nicozorza/TP_Final_Embebidos/firmware_edu-ciaa/sapi_examples/documentation/docs/assets/pdf/sAPI-02-Diseño.pdf

Docs » Diseño

# Principios de diseño

Se basa en denir periféricos abstractos y lo más genéricos posibles, logrando independencia de la arquitectura. Esta independecia es deseada para que actúe como HAL (Hardware Abstraction Layer).

Se diseña además una API sencilla en la que la mayoría de las funciones son del tipo:

nombreModuloCong();
nombreModuloRead();
nombreModuloWrite();

Utiliza nombres sencillos al estilo de la biblioteca Wiring, pero en lugar del concepto de pin utiliza el concepto periférico, para lograr una API unicada, sin importar el número de pines que tenga un cierto perifécico.

## Capas de software
