nicozorza/TP_Final_Embebidos/Bitacora/imagenes/19 resultados con el ventilador.jpg

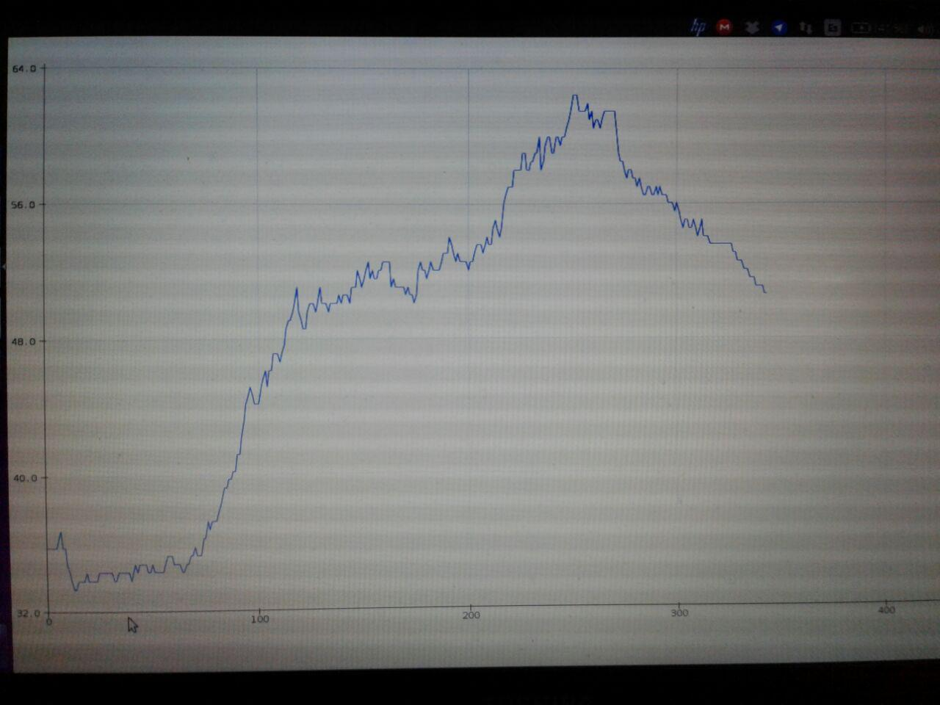
Bitacora/imagenes/19 resultados con el ventilador.jpg
