nicozorza/TP_Final_Embebidos/Bitacora/imagenes/20 resultados 200 grados.jpg

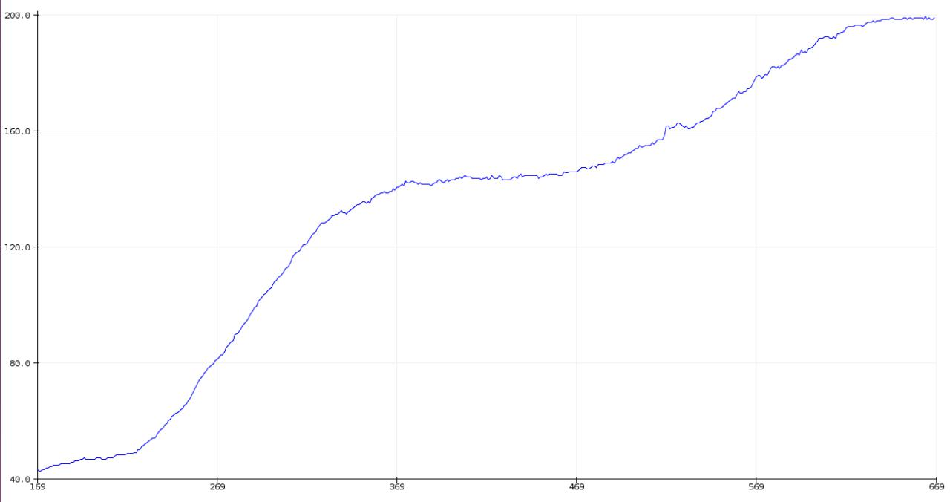
Bitacora/imagenes/20 resultados 200 grados.jpg
