nicozorza/TP_Final_Embebidos/Bitacora/imagenes/2 detector de fase senger.jpg

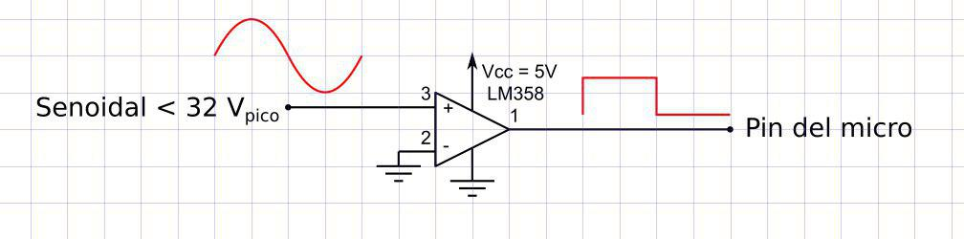
Bitacora/imagenes/2 detector de fase senger.jpg
