nicozorza/TP_Final_Embebidos/Bitacora/imagenes/3 detector de fase nuevo.jpg

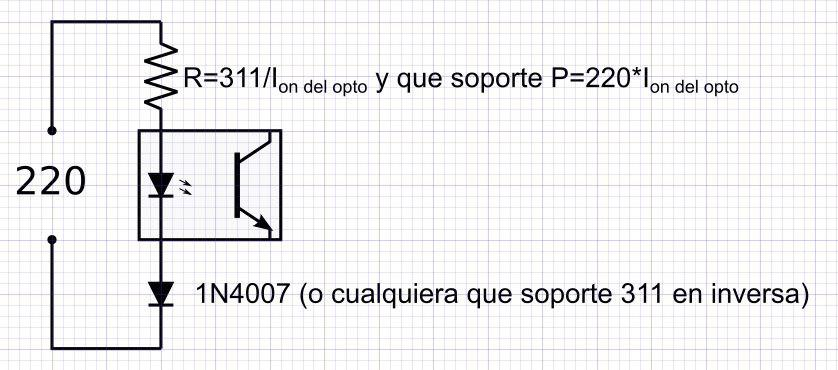
Bitacora/imagenes/3 detector de fase nuevo.jpg
