nicozorza/TP_Final_Embebidos/Bitacora/imagenes/12 termocupla.png

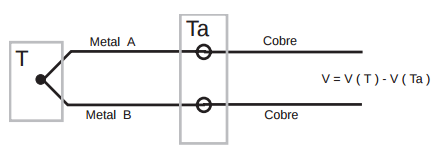
Bitacora/imagenes/12 termocupla.png
