nicozorza/TP_Final_Embebidos/Bitacora/imagenes/17 foto placa 1.jpg

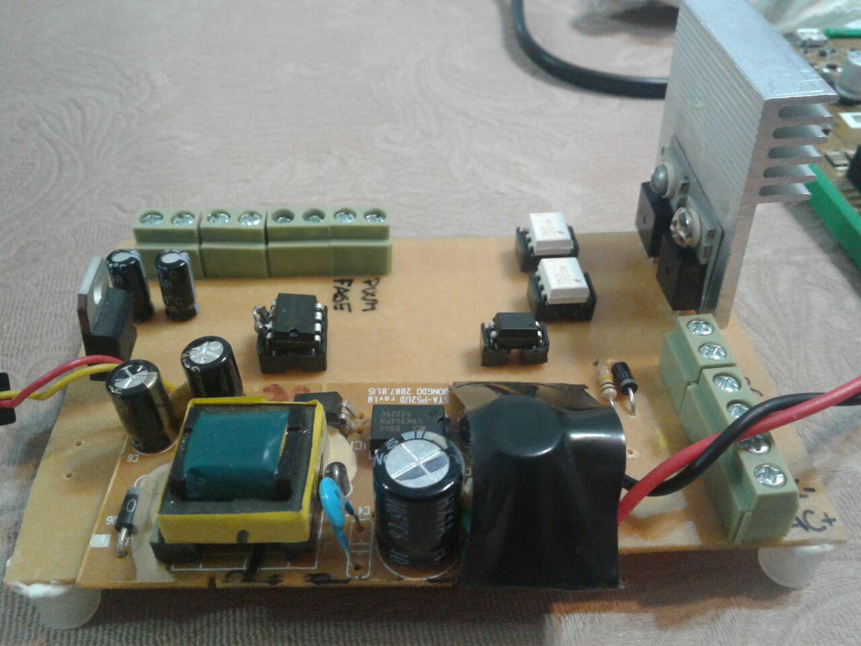
Bitacora/imagenes/17 foto placa 1.jpg
