nicozorza/TP_Final_Embebidos/Bitacora/imagenes/17 foto placa 2.jpg

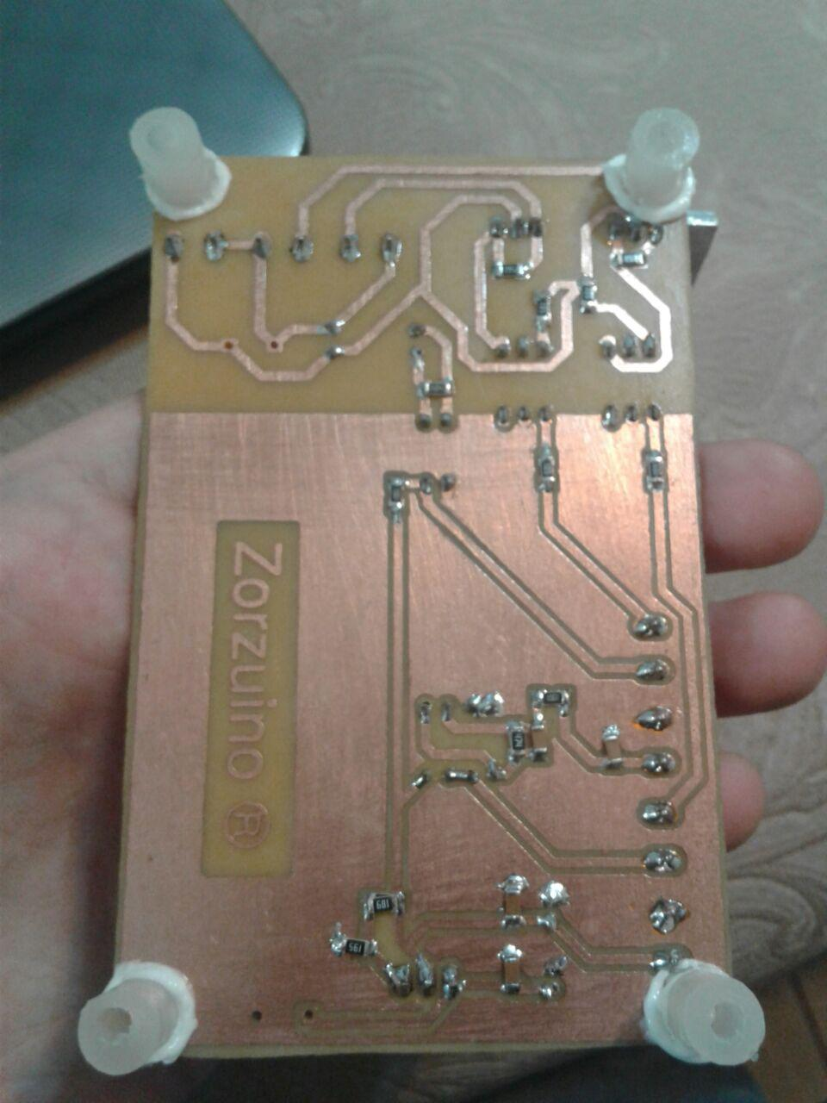
Bitacora/imagenes/17 foto placa 2.jpg
