nicozorza/TP_Final_Embebidos/Bitacora/imagenes/21 villada 1 dos triacs en paralelo.jpg

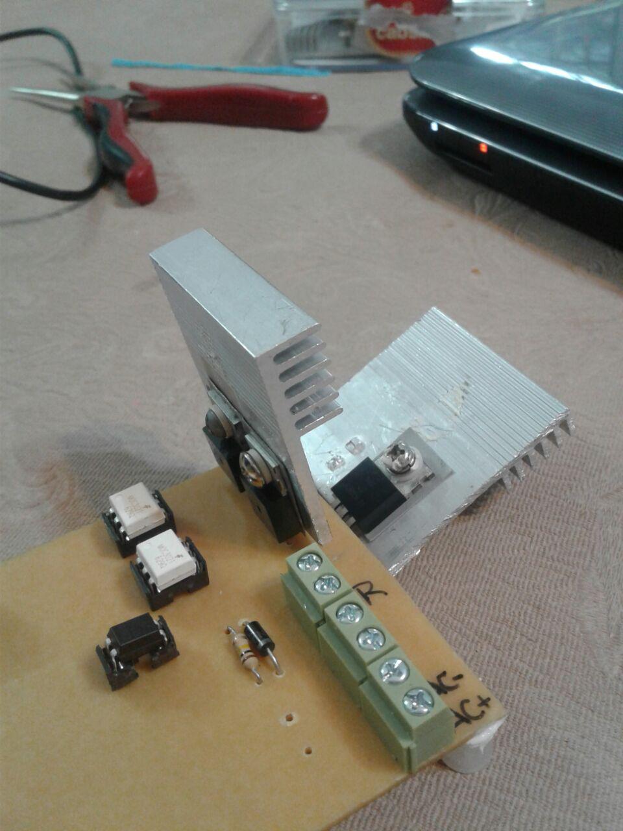
Bitacora/imagenes/21 villada 1 dos triacs en paralelo.jpg
