nicozorza/TP_Final_Embebidos/Bitacora/imagenes/21 villada 2 tres triacs en paralelo.jpg

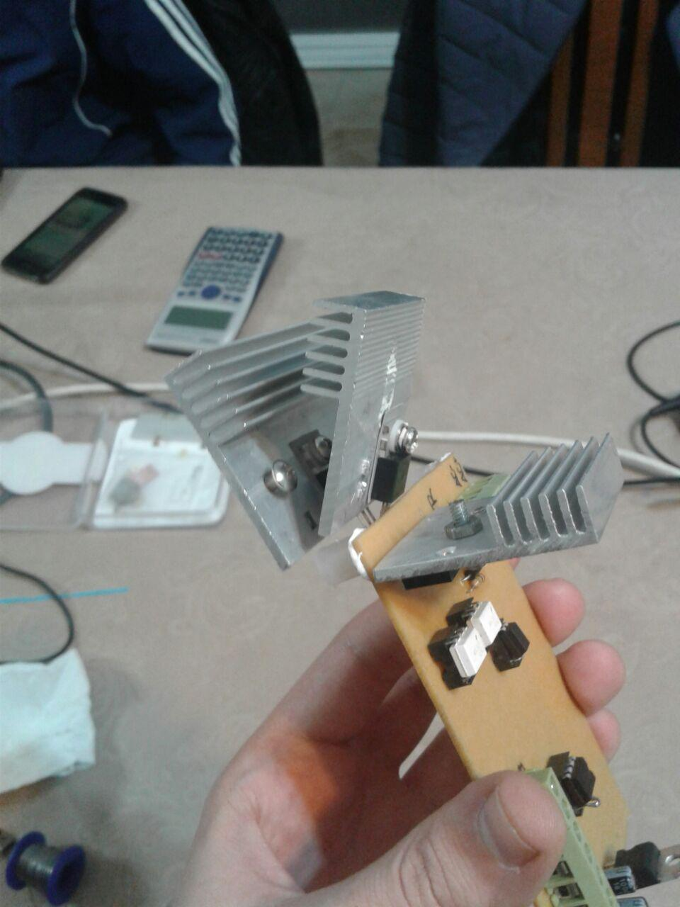
Bitacora/imagenes/21 villada 2 tres triacs en paralelo.jpg
