nicozorza/TP_Final_Embebidos/Bitacora/imagenes/22 primer soldadura 2.jpg

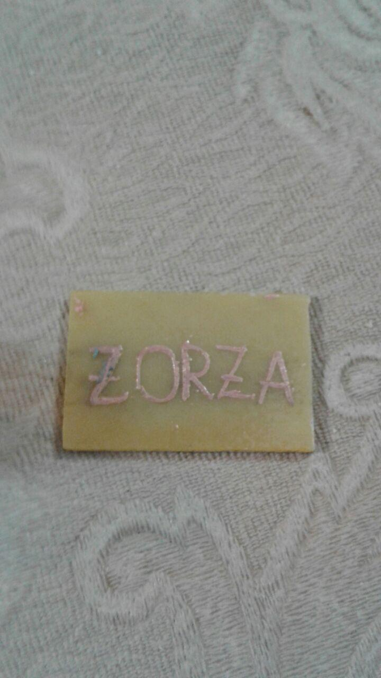
Bitacora/imagenes/22 primer soldadura 2.jpg
