nicozorza/TP_Final_Embebidos/Bitacora/imagenes/22 primer soldadura 3.jpg

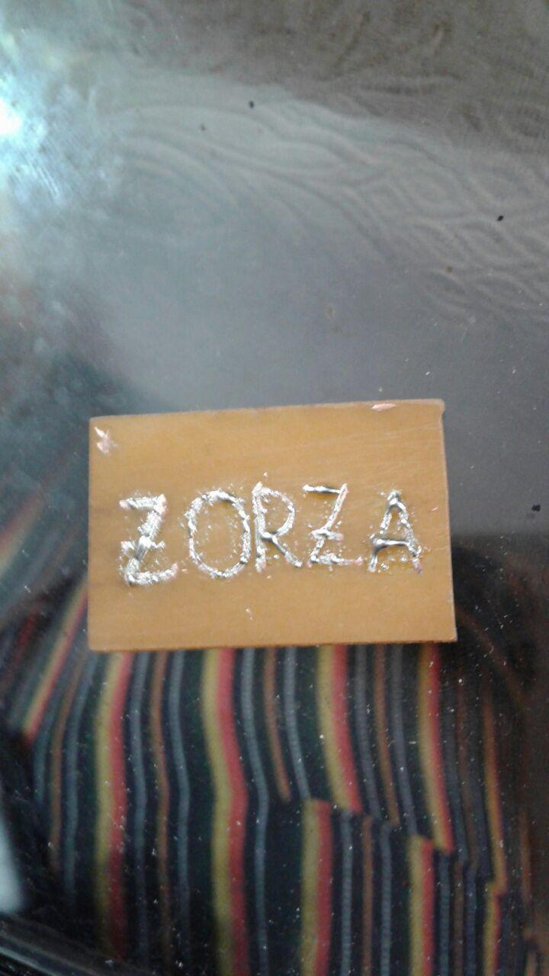
Bitacora/imagenes/22 primer soldadura 3.jpg
