nicozorza/TP_Final_Embebidos/Bitacora/imagenes/soldadura final.png

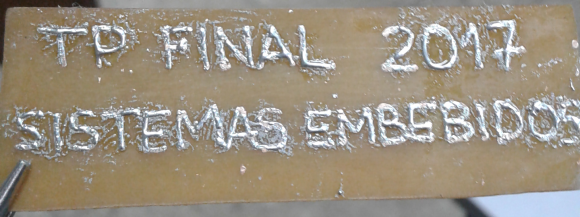
Bitacora/imagenes/soldadura final.png
