nicozorza/TP_Final_Embebidos/Hojas de datos/edu-ciaa-nxp_pinout_a4_v4r2_es.pdf

# EDU-CIAA-NXP Asignación de pines

# Pernia

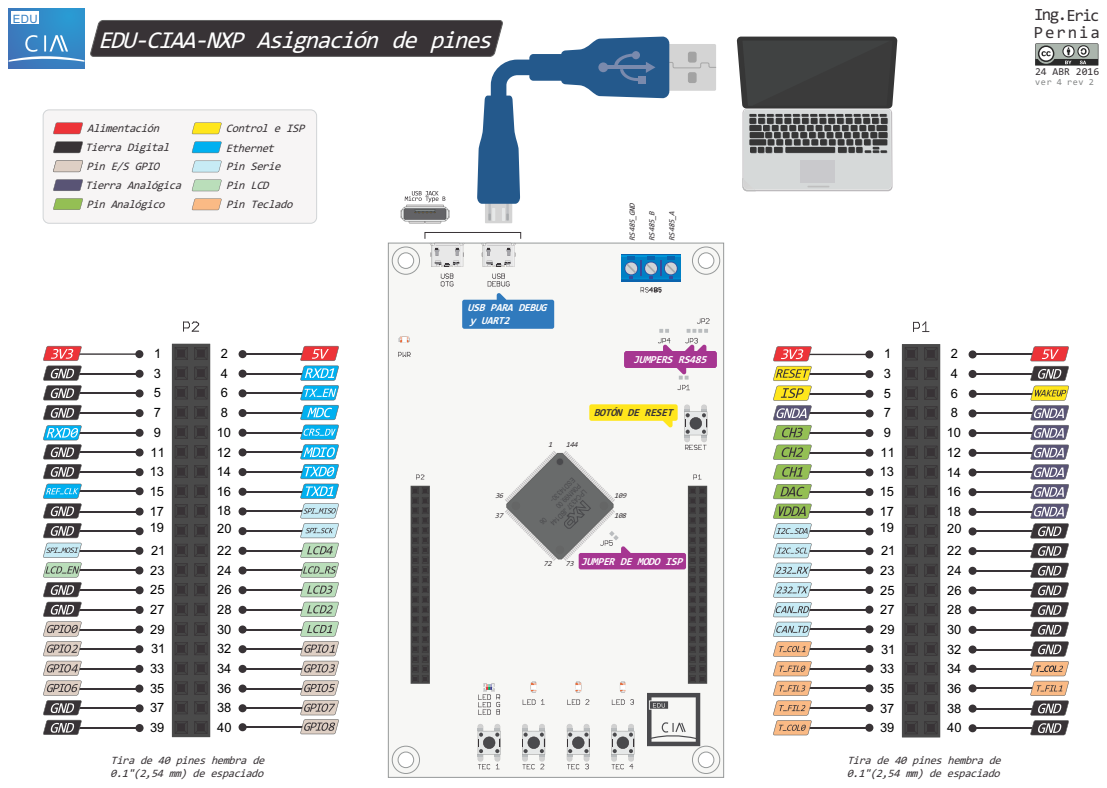
[picture p43: page 1]
Alimentación; Tierra Digital; Pin Analógico; Tierra Analógica; Pin E/S GPIO; Pin Serie; Control e ISP; Pin LCD; Pin Teclado; Ethernet; EDU; LPC4337 JBD144; ESD14330-; JUMPER DE MODO ISP; 24 ABR 2016 ver 4 rev 2; Ing.Eric; JUMPERS RS485; RS485_GND

USB PARA DEBUG
y UART2

BOTÓN DE RESET

Tira de 40 pines hembra de
0.1"(2,54 mm) de espaciado

# Pernia

# Ing.Eric

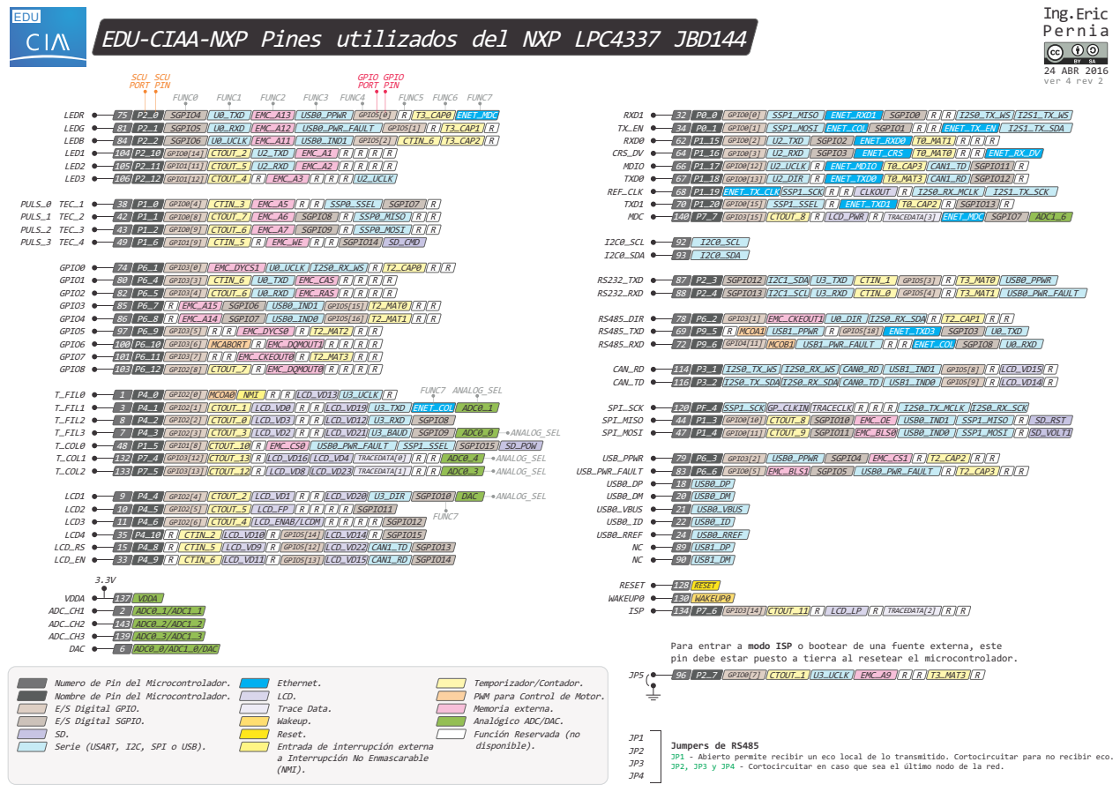
[picture p44: page 2]

EDU-CIAA-NXP Pines utilizados del NXP LPC4337 JBD144

Para entrar a modo ISP o bootear de una fuente externa, este
pin debe estar puesto a tierra al resetear el microcontrolador.

Numero de Pin del Microcontrolador.
Nombre de Pin del Microcontrolador.
E/S Digital GPIO.
E/S Digital SGPIO.
Serie (USART, I2C, SPI o USB).

Temporizador/Contador.
PWM para Control de Motor.
Memoria externa.
Analógico ADC/DAC.
Función Reservada (no

Jumpers de RS485
JP1 Abierto permite recibir un eco local de lo transmitido. Cortocircuitar para no recibir eco.
JP2, JP3 y JP4 Cortocircuitar en caso que sea el último nodo de la red.
