nicozorza/TP_Final_Embebidos/firmware_edu-ciaa/sapi_examples/documentation/docs/assets/pdf/EDU-CIAA-NXP_Pinout_A4_v4r3_ES.pdf

# EDU-CIAA-NXP Asignación de pines

# Pernia

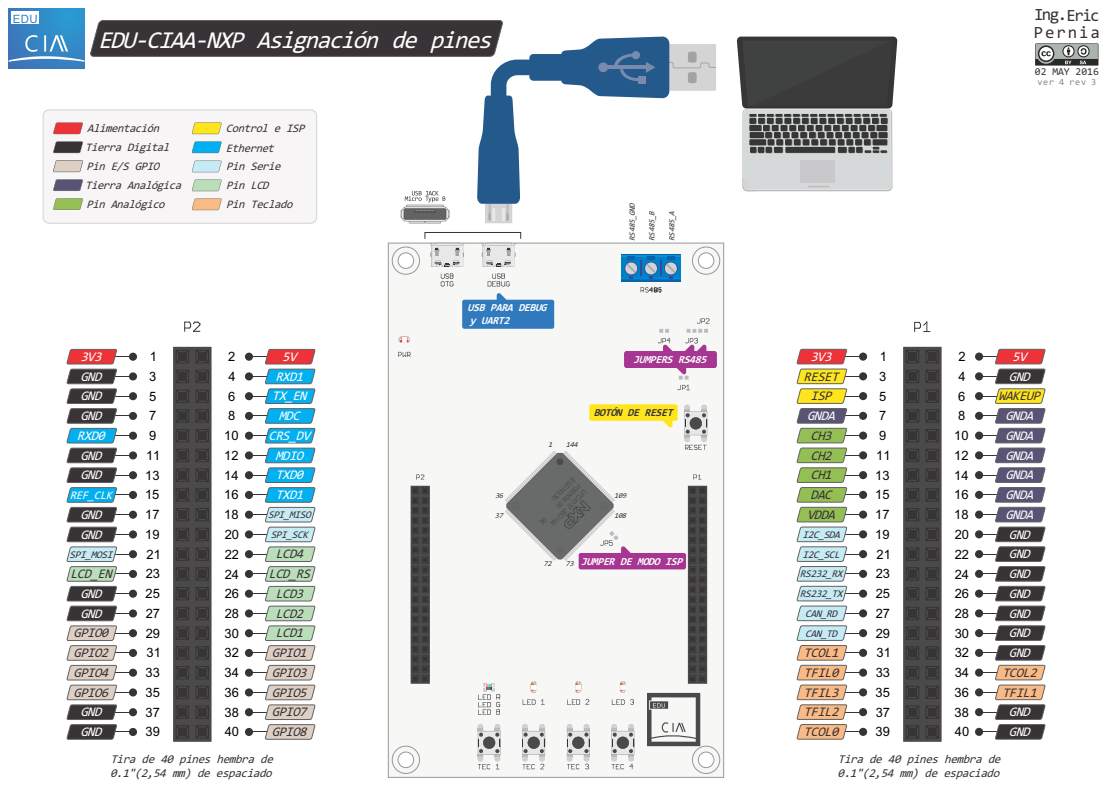
[picture p45: page 1]
Alimentación; Tierra Digital; Pin Analógico; Tierra Analógica; Pin E/S GPIO; Pin Serie; Control e ISP; Pin LCD; Pin Teclado; Ethernet; EDU; LPC4337 JBD144; ESD14330-; JUMPER DE MODO ISP; JUMPERS RS485; RS485_GND; 02 MAY 2016 ver 4 rev 3; Ing.Eric; GND; GNDA; WAKEUP; TCOL2; TFIL1; TCOL1; TFIL0; TFIL3; TFIL2; TCOL0; ISP; RESET; DAC; VDDA; I2C_SDA; I2C_SCL; CAN_RD; CAN_TD; GPIO2; GPIO4; GPIO6; GPIO0; GPIO8; GPIO7; GPIO5; GPIO3; GPIO1; LCD1; LCD2; LCD3; LCD_EN; LCD_RS; LCD4; SPI_MISO; SPI_SCK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

USB PARA DEBUG
y UART2

BOTÓN DE RESET

Tira de 40 pines hembra de
0.1"(2,54 mm) de espaciado

# Pernia

# Ing.Eric

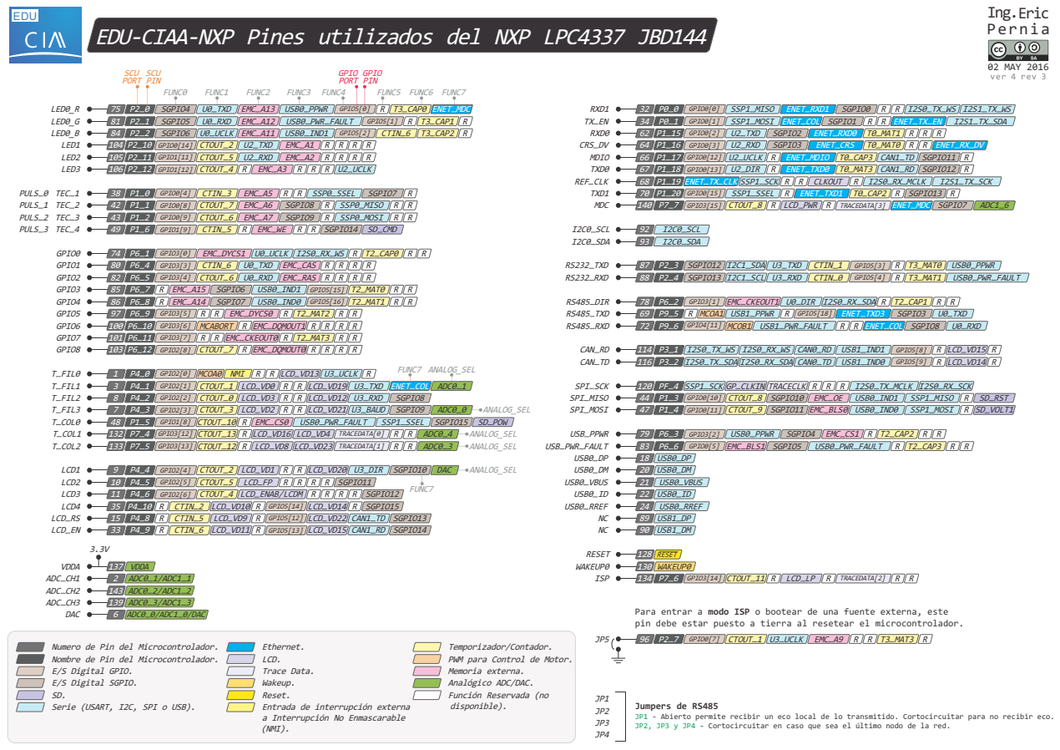
[picture p46: page 2]

EDU-CIAA-NXP Pines utilizados del NXP LPC4337 JBD144

Para entrar a modo ISP o bootear de una fuente externa, este
pin debe estar puesto a tierra al resetear el microcontrolador.

Numero de Pin del Microcontrolador.
Nombre de Pin del Microcontrolador.
E/S Digital GPIO.
E/S Digital SGPIO.
Serie (USART, I2C, SPI o USB).

Temporizador/Contador.
PWM para Control de Motor.
Memoria externa.
Analógico ADC/DAC.
Función Reservada (no

Jumpers de RS485
JP1 Abierto permite recibir un eco local de lo transmitido. Cortocircuitar para no recibir eco.
JP2, JP3 y JP4 Cortocircuitar en caso que sea el último nodo de la red.
