nicozorza/TP_Final_Embebidos/PCB/PCB Embebidos/esquematico.pdf

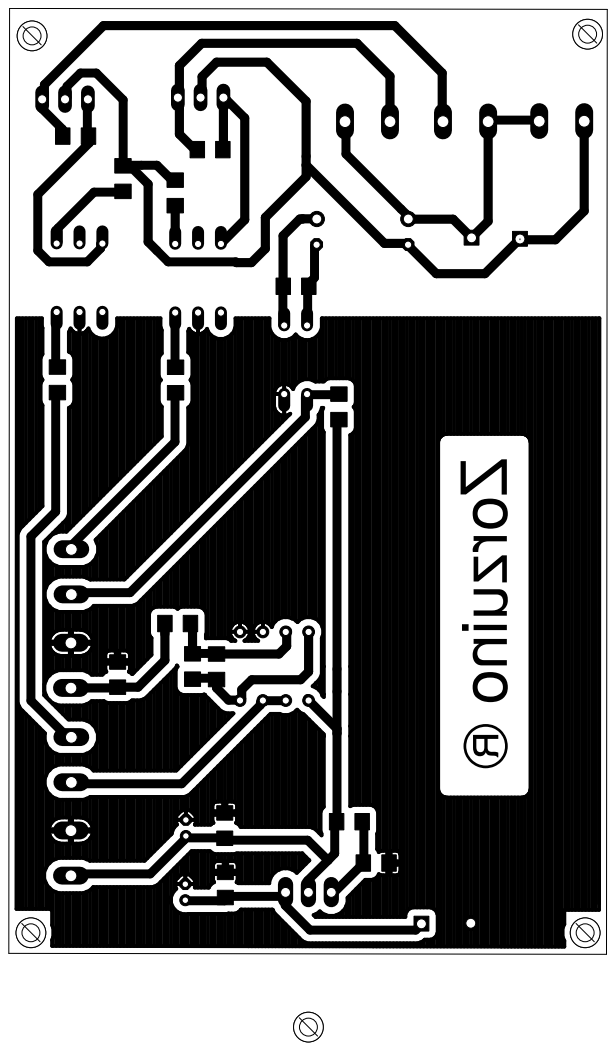
[picture p47: page 1]
