nicozorza/TP_Final_Embebidos/PCB/PCB Embebidos/esquematico.brd

## EAGLE design PCB/PCB Embebidos/esquematico.brd (2017-06-10)

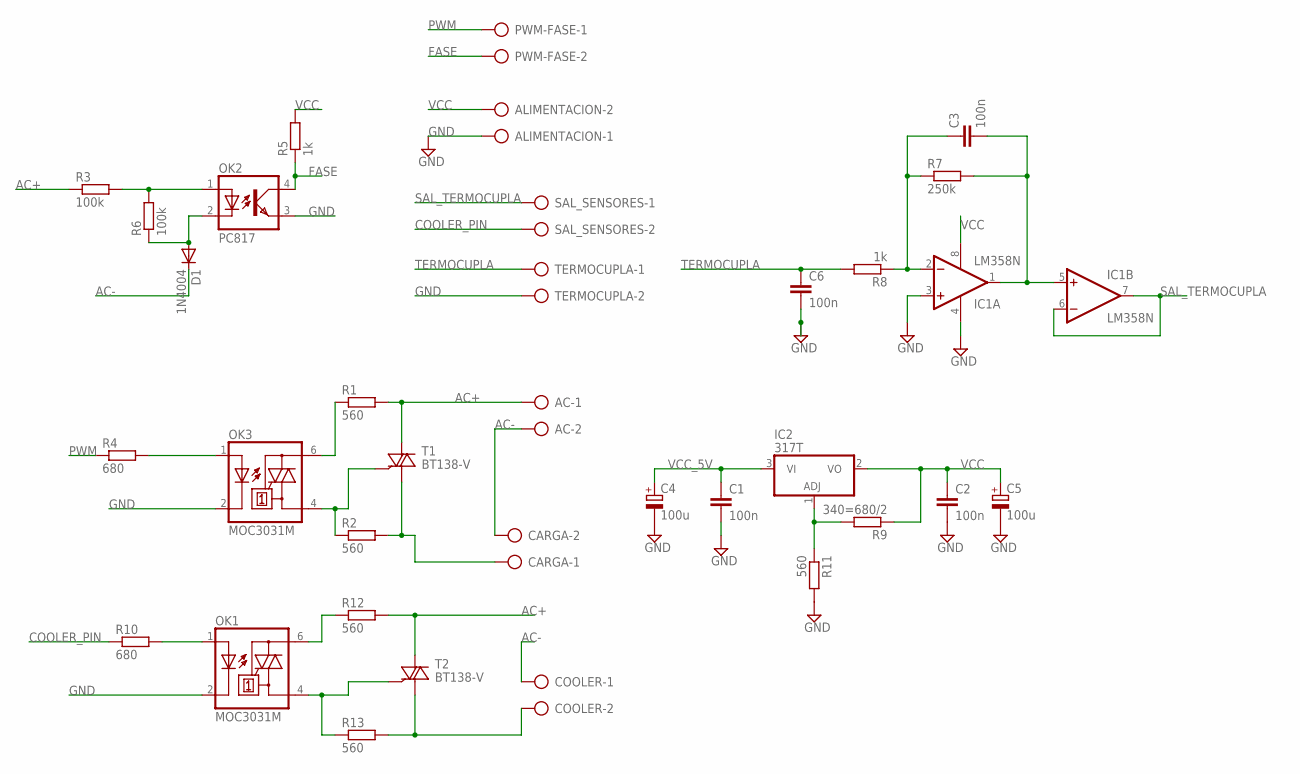
[picture p48: schematic esquematico.sch]

Parts:
AC: AK300/2
ALIMENTACION: AK300/2
C1, C2, C3, C6: 100n; C1206
C4, C5: 100u; E1,8-4
CARGA: AK300/2
COOLER: AK300/2
D1: 1N4004; DO41-10
IC1: LM358N; DIL08
IC2: 317T; TO220H
OK1, OK3: MOC3031M; DIL06
OK2: PC817; DIL04
PWM-FASE: AK300/2
R1, R2, R11, R12, R13: 560; R1206
R3: 100k; 0207/10
R4, R10: 680; R1206
R5, R8: 1k; R1206
R6: 100k; R1206
R7: 250k; R1206
R9: 340=680/2; R1206
SAL_SENSORES: AK300/2
T1, T2: BT138-V; TO220BV
TERMOCUPLA: AK300/2

Connections:
AC+: AC.1, R1.2, R3.1, R12.2, T1.T2 (A2), T2.T2 (A2)
AC-: AC.2, CARGA.2, COOLER.1, D1.C
COOLER_PIN: R10.1, SAL_SENSORES.2
FASE: OK2.4 (COL), PWM-FASE.2, R5.1
GND: ALIMENTACION.1, C1.2, C2.2, C4.-, C5.-, C6.2, IC1.3 (+IN), IC1.4 (V-), OK1.2 (C), OK2.3 (EMIT), OK3.2 (C), R11.2, TERMOCUPLA.2
unnamed: OK3.1 (A), R4.2
unnamed: OK3.6 (A2), R1.1
unnamed: OK2.1 (A), R3.2, R6.2
unnamed: CARGA.1, R2.2, T1.T1 (A1)
unnamed: C3.1, IC1.2 (-IN), R7.1, R8.1
unnamed: IC2.1 (ADJ), R9.2, R11.1
unnamed: C3.2, IC1.1 (OUT), IC1.5 (+IN), R7.2
unnamed: OK3.4 (A1), R2.1, T1.G
unnamed: D1.A, OK2.2 (C), R6.1
unnamed: OK1.1 (A), R10.2
unnamed: OK1.6 (A2), R12.1
unnamed: OK1.4 (A1), R13.1, T2.G
unnamed: COOLER.2, R13.2, T2.T1 (A1)
PWM: PWM-FASE.1, R4.1
SAL_TERMOCUPLA: IC1.6 (-IN), IC1.7 (OUT), SAL_SENSORES.1
TERMOCUPLA: C6.1, R8.2, TERMOCUPLA.1
VCC: ALIMENTACION.2, C2.1, C5.+, IC1.8 (V+), IC2.2 (VO), R5.2, R9.1
VCC_5V: C1.1, C4.+, IC2.3 (VI)

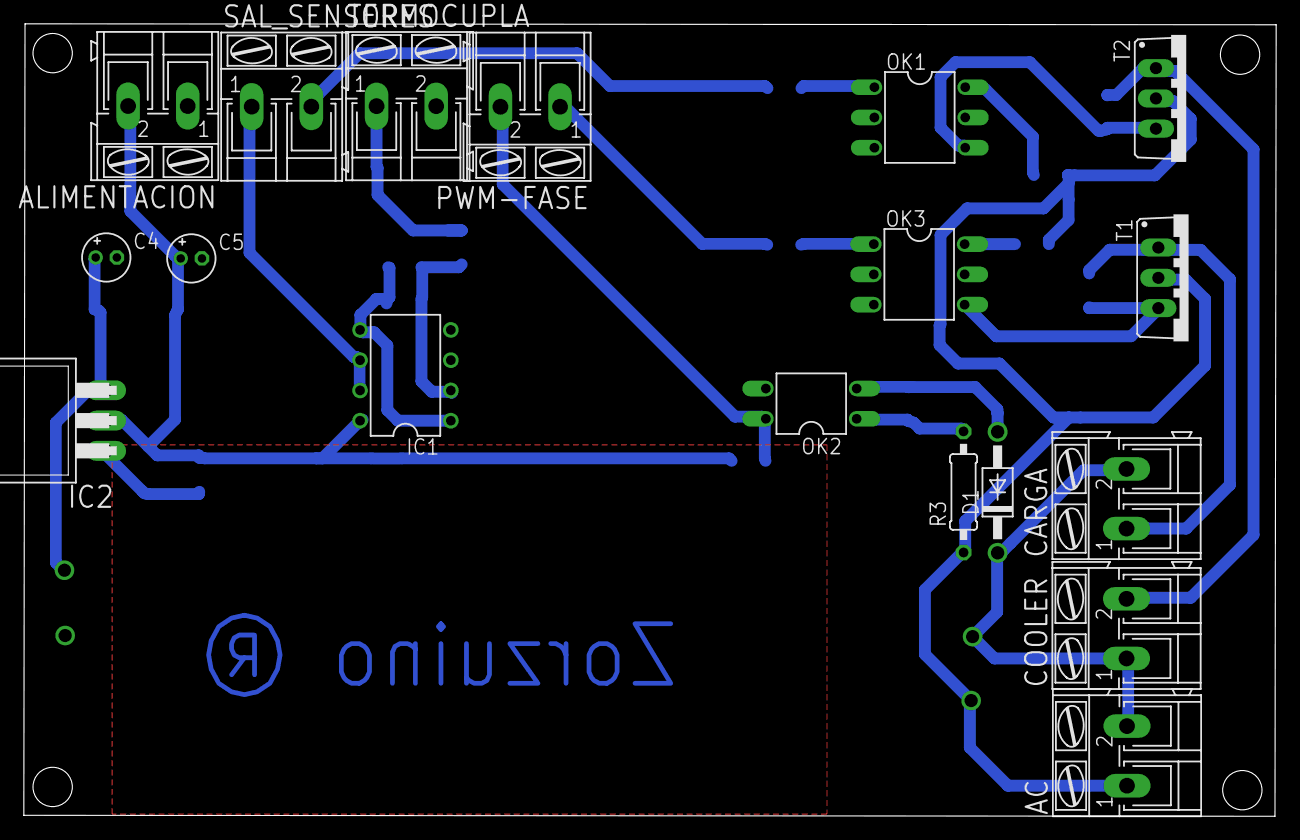
[picture p49: board esquematico.brd from above]

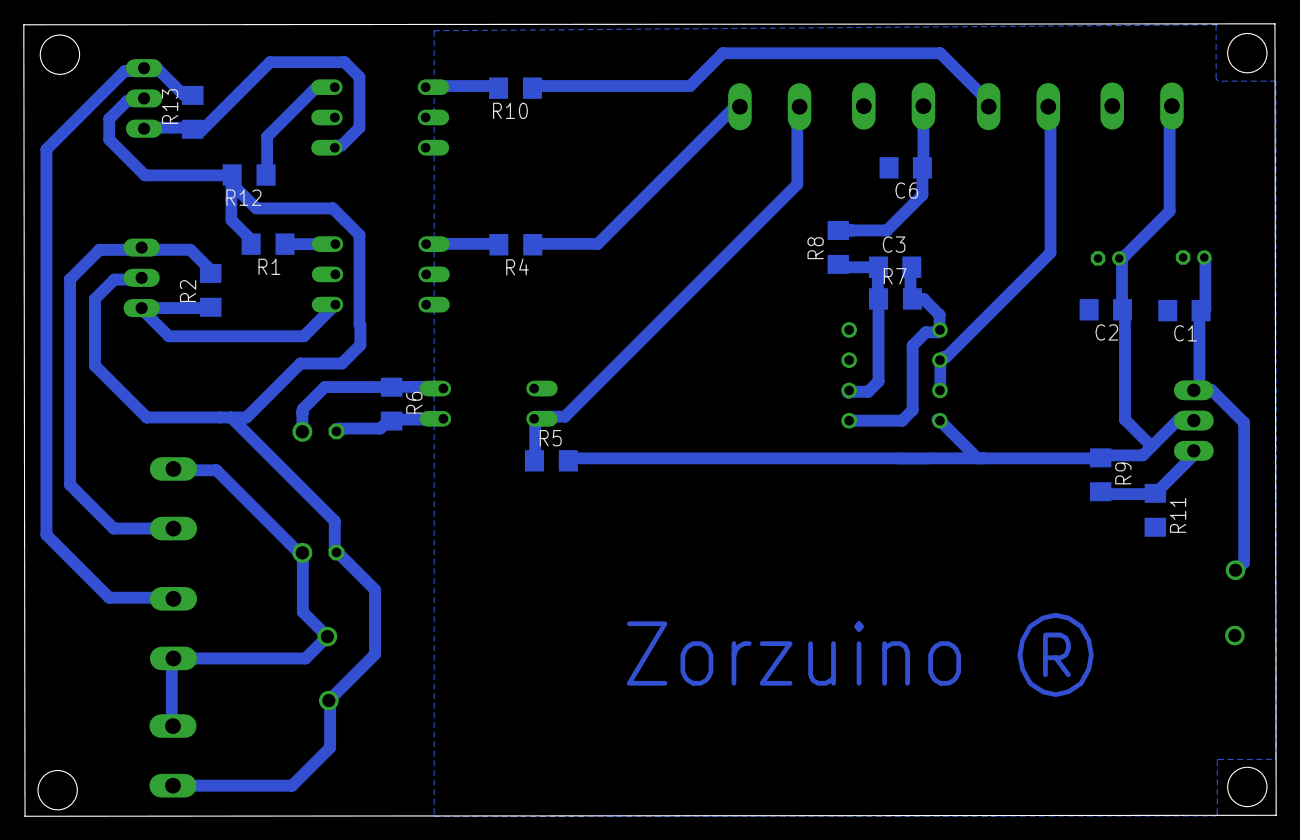
[picture p50: board esquematico.brd from below]

Board: 2 copper layers, 105.1 x 66.5 mm, 34 parts (16 on the bottom side), 23 nets.
