nicozorza/TP_Final_Embebidos/Codigo final/TP_Lio/lpc_board_nxp_lpcxpresso_4337/src/board_sysinit.c

/*
 * Copyright(C) NXP Semiconductors, 2012
 * All rights reserved.
 *
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
 * Permission to use, copy, modify, and distribute this software and its
 * documentation is hereby granted, under NXP Semiconductors' and its
 * licensor's relevant copyrights in the software, without fee, provided that it
 * is used in conjunction with NXP Semiconductors microcontrollers.  This
 * copyright, permission, and disclaimer notice must appear in all copies of
 * this code.
 */

#include "board.h"

/* The System initialization code is called prior to the application and
   initializes the board for run-time operation. Board initialization
   includes clock setup and default pin muxing configuration. */

/*****************************************************************************
 * Private types/enumerations/variables
 ****************************************************************************/

/* Structure for initial base clock states */
struct CLK_BASE_STATES {
	CHIP_CGU_BASE_CLK_T clk;	/* Base clock */
	CHIP_CGU_CLKIN_T clkin;	/* Base clock source, see UM for allowable souorces per base clock */
	bool autoblock_enab;/* Set to true to enable autoblocking on frequency change */
	bool powerdn;		/* Set to true if the base clock is initially powered down */
};

/* Initial base clock states are mostly on */
STATIC const struct CLK_BASE_STATES InitClkStates[] = {

	/* Ethernet Clock base */
	{CLK_BASE_PHY_TX, CLKIN_ENET_TX, true, false},
	{CLK_BASE_PHY_RX, CLKIN_ENET_TX, true, false},

	/* Clocks derived from dividers */
	{CLK_BASE_USB1, CLKIN_IDIVD, true, true}
};

STATIC const PINMUX_GRP_T pinmuxing[] = {

	/* Board LEDs */
#if defined(BOARD_NXP_LPCXPRESSO_4337)
	{0x6, 9, (SCU_MODE_INBUFF_EN | SCU_MODE_PULLUP | SCU_MODE_FUNC0)},
	{0x6, 11, (SCU_MODE_INBUFF_EN | SCU_MODE_PULLUP | SCU_MODE_FUNC0)},
	{0x2, 7, (SCU_MODE_INBUFF_EN | SCU_MODE_PULLUP | SCU_MODE_FUNC0)},
#endif

#if defined(BOARD_EDU_CIAA_NXP)
	{0x2,  0, (SCU_MODE_INBUFF_EN | SCU_MODE_PULLUP | SCU_MODE_FUNC4)},	/* LEDR P2_0 FUNC4 => GPIO5[0] */
	{0x2,  1, (SCU_MODE_INBUFF_EN | SCU_MODE_PULLUP | SCU_MODE_FUNC4)},	/* LEDG P2_1 FUNC4 => GPIO5[1] */
	{0x2,  2, (SCU_MODE_INBUFF_EN | SCU_MODE_PULLUP | SCU_MODE_FUNC4)},	/* LEDB P2_2 FUNC4 => GPIO5[2] */
	{0x2, 10, (SCU_MODE_INBUFF_EN | SCU_MODE_PULLUP | SCU_MODE_FUNC0)},	/* LED1 P2_10 FUNC0 => GPIO0[14] */
	{0x2, 11, (SCU_MODE_INBUFF_EN | SCU_MODE_PULLUP | SCU_MODE_FUNC0)},	/* LED2 P2_11 FUNC0 => GPIO1[11] */
	{0x2, 12, (SCU_MODE_INBUFF_EN | SCU_MODE_PULLUP | SCU_MODE_FUNC0)},	/* LED1 P2_12 FUNC0 => GPIO1[12] */
#endif

	/* Board Buttons */
	{0x1, 0, (SCU_MODE_PULLUP | SCU_MODE_INBUFF_EN | SCU_MODE_ZIF_DIS | SCU_MODE_FUNC0)},	/* TEC1 P1_0 FUNC0 => GPIO0[4] */
	{0x1, 1, (SCU_MODE_PULLUP | SCU_MODE_INBUFF_EN | SCU_MODE_ZIF_DIS | SCU_MODE_FUNC0)},	/* TEC2 P1_1 FUNC0 => GPIO0[8] */
	{0x1, 2, (SCU_MODE_PULLUP | SCU_MODE_INBUFF_EN | SCU_MODE_ZIF_DIS | SCU_MODE_FUNC0)},	/* TEC3 P1_2 FUNC0 => GPIO0[9] */
	{0x1, 6, (SCU_MODE_PULLUP | SCU_MODE_INBUFF_EN | SCU_MODE_ZIF_DIS | SCU_MODE_FUNC0)},	/* TEC4 P1_6 FUNC1 => GPIO0[9] */

	/* USB1 V-BUS Enable pin */
	{0x2, 5, (SCU_MODE_INBUFF_EN | SCU_MODE_PULLUP | SCU_MODE_FUNC4)},

	/* ENET Pin mux (RMII Pins) */
#if defined(BOARD_NXP_LPCXPRESSO_4337)
	{0x1, 18, (SCU_MODE_HIGHSPEEDSLEW_EN | SCU_MODE_INACT | SCU_MODE_ZIF_DIS | SCU_MODE_FUNC3)}, /* TXD0 */
	{0x1, 20, (SCU_MODE_HIGHSPEEDSLEW_EN | SCU_MODE_INACT | SCU_MODE_ZIF_DIS | SCU_MODE_FUNC3)}, /* TXD1 */
	{0x0, 1,  (SCU_MODE_HIGHSPEEDSLEW_EN | SCU_MODE_INACT | SCU_MODE_ZIF_DIS | SCU_MODE_FUNC6)}, /* TXEN */
	{0x1, 15, (SCU_MODE_HIGHSPEEDSLEW_EN | SCU_MODE_INACT | SCU_MODE_INBUFF_EN | SCU_MODE_ZIF_DIS | SCU_MODE_FUNC3)}, /* RXD0 */
	{0x0, 0, (SCU_MODE_HIGHSPEEDSLEW_EN | SCU_MODE_INACT | SCU_MODE_INBUFF_EN | SCU_MODE_ZIF_DIS | SCU_MODE_FUNC2)},  /* RXD1 */
	{0x1, 16, (SCU_MODE_HIGHSPEEDSLEW_EN | SCU_MODE_INACT | SCU_MODE_INBUFF_EN | SCU_MODE_ZIF_DIS | SCU_MODE_FUNC7)}, /* CRS_DV */
	{0x1, 17, (SCU_MODE_HIGHSPEEDSLEW_EN | SCU_MODE_INACT | SCU_MODE_INBUFF_EN | SCU_MODE_ZIF_DIS | SCU_MODE_FUNC3)}, /* MDIO */
	{0x2, 0,  (SCU_MODE_HIGHSPEEDSLEW_EN | SCU_MODE_INACT | SCU_MODE_ZIF_DIS | SCU_MODE_FUNC7)}, /* MDC */
	{0x1, 19, (SCU_MODE_HIGHSPEEDSLEW_EN | SCU_MODE_INACT | SCU_MODE_INBUFF_EN | SCU_MODE_ZIF_DIS | SCU_MODE_FUNC0)}, /* REFCLK */
#endif
};

/*****************************************************************************
 * Public types/enumerations/variables
 ****************************************************************************/

/*****************************************************************************
 * Private functions
 ****************************************************************************/

/*****************************************************************************
 * Public functions
 ****************************************************************************/

/* Sets up system pin muxing */
void Board_SetupMuxing(void)
{
	/* Setup system level pin muxing */
	Chip_SCU_SetPinMuxing(pinmuxing, sizeof(pinmuxing) / sizeof(PINMUX_GRP_T));
}

/* Set up and initialize clocking prior to call to main */
void Board_SetupClocking(void)
{
	int i;

	/* Enable Flash acceleration and setup wait states */
	Chip_CREG_SetFlashAcceleration(MAX_CLOCK_FREQ);

	/* Setup System core frequency to MAX_CLOCK_FREQ */
#if defined(BOARD_NXP_LPCXPRESSO_4337)
	Chip_SetupCoreClock(CLKIN_CRYSTAL, MAX_CLOCK_FREQ, true);
#endif

#if defined (BOARD_EDU_CIAA_NXP)
	Chip_SetupCoreClock(CLKIN_CRYSTAL, MAX_CLOCK_FREQ, true);
#endif

	/* Setup system base clocks and initial states. This won't enable and
	   disable individual clocks, but sets up the base clock sources for
	   each individual peripheral clock. */
	for (i = 0; i < (sizeof(InitClkStates) / sizeof(InitClkStates[0])); i++) {
		Chip_Clock_SetBaseClock(InitClkStates[i].clk, InitClkStates[i].clkin,
								InitClkStates[i].autoblock_enab, InitClkStates[i].powerdn);
	}

	/* Reset and enable 32Khz oscillator */
	LPC_CREG->CREG0 &= ~((1 << 3) | (1 << 2));
	LPC_CREG->CREG0 |= (1 << 1) | (1 << 0);
}

/* Set up and initialize hardware prior to call to main */
void Board_SystemInit(void)
{
	/* Setup system clocking and memory. This is done early to allow the
	   application and tools to clear memory and use scatter loading to
	   external memory. */
	Board_SetupMuxing();
	Board_SetupClocking();
}
