nicozorza/TP_Final_Embebidos/Pruebas/Prueba_detectar_fase/periph_pinint/example/src/pinint.c

/*
 * @brief Pin Interrupt example
 *
 * @note
 * Copyright(C) NXP Semiconductors, 2013
 * All rights reserved.
 *
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
 * @par
 * Permission to use, copy, modify, and distribute this software and its
 * documentation is hereby granted, under NXP Semiconductors' and its
 * licensor's relevant copyrights in the software, without fee, provided that it
 * is used in conjunction with NXP Semiconductors microcontrollers.  This
 * copyright, permission, and disclaimer notice must appear in all copies of
 * this code.
 */

#include "chip.h"
#include "board.h"

/*****************************************************************************
 * Private types/enumerations/variables
 ****************************************************************************/
#define BOARD_NXP_LPCXPRESSO_4337

#if defined(BOARD_HITEX_EVA_4350) || defined(BOARD_HITEX_EVA_1850) || defined(BOARD_NXP_LPCXPRESSO_4337)

/* GPIO pin for PININT interrupt.  The only switch available on this board is
   the ISP switch input.  The other switches are connected to an I2C device. */
#define TEST_INPUT_PIN          4	/* GPIO pin number mapped to PININT */
#define TEST_INPUT_PORT         3	/* GPIO port number mapped to PININT */
#define TEST_INPUT_PIN_PORT     6
#define TEST_INPUT_PIN_BIT      5
#define TEST_INPUT_MODE_FUNC    SCU_MODE_FUNC0
#define PININT_INDEX   0	/* PININT index used for GPIO mapping */
#define PININT_IRQ_HANDLER  GPIO0_IRQHandler	/* GPIO interrupt IRQ function name */
#define PININT_NVIC_NAME    PIN_INT0_IRQn	/* GPIO interrupt NVIC interrupt name */

#elif defined(BOARD_KEIL_MCB_4357) || defined(BOARD_KEIL_MCB_1857)

/* GPIO pin for PININT interrupt.   This is the P4_0 button. */
#define TEST_INPUT_PIN          0	/* GPIO pin number mapped to PININT */
#define TEST_INPUT_PORT         2	/* GPIO port number mapped to PININT */
#define TEST_INPUT_PIN_PORT     4
#define TEST_INPUT_PIN_BIT      0
#define TEST_INPUT_MODE_FUNC    SCU_MODE_FUNC0
#define PININT_INDEX   0	/* PININT index used for GPIO mapping */
#define PININT_IRQ_HANDLER  GPIO0_IRQHandler	/* GPIO interrupt IRQ function name */
#define PININT_NVIC_NAME    PIN_INT0_IRQn	/* GPIO interrupt NVIC interrupt name */

#elif defined(BOARD_NGX_XPLORER_1830) || defined(BOARD_NGX_XPLORER_4330)

// FIXME: - These boards were not tested with IAR toolchain.  There are errors
//          downloading to flash, etc.

/* GPIO pin for PININT interrupt.   This is the USER_SWITCH. */
#define TEST_INPUT_PIN          7	/* GPIO pin number mapped to PININT */
#define TEST_INPUT_PORT         0	/* GPIO port number mapped to PININT */
#define TEST_INPUT_PIN_PORT     2
#define TEST_INPUT_PIN_BIT      7
#define TEST_INPUT_MODE_FUNC    SCU_MODE_FUNC0
#define PININT_INDEX   0	/* PININT index used for GPIO mapping */
#define PININT_IRQ_HANDLER  GPIO0_IRQHandler	/* GPIO interrupt IRQ function name */
#define PININT_NVIC_NAME    PIN_INT0_IRQn	/* GPIO interrupt NVIC interrupt name */

#elif defined(BOARD_NXP_LPCLINK2_4370)

/* GPIO pin for PININT interrupt.   This is JP1.  Install JP1 to invoke interrupt. */
#define TEST_INPUT_PIN          7	/* GPIO pin number mapped to PININT */
#define TEST_INPUT_PORT         5	/* GPIO port number mapped to PININT */
#define TEST_INPUT_PIN_PORT     2
#define TEST_INPUT_PIN_BIT      8
#define TEST_INPUT_MODE_FUNC    SCU_MODE_FUNC4
#define PININT_INDEX   0	/* PININT index used for GPIO mapping */
#define PININT_IRQ_HANDLER  GPIO0_IRQHandler	/* GPIO interrupt IRQ function name */
#define PININT_NVIC_NAME    PIN_INT0_IRQn	/* GPIO interrupt NVIC interrupt name */

#else
#error "PININT Interrupt not configured for this example"
#endif /* defined(BOARD_HITEX_EVA_4350) || defined(BOARD_HITEX_EVA_1850) */

/*****************************************************************************
 * Public types/enumerations/variables
 ****************************************************************************/

/*****************************************************************************
 * Private functions
 ****************************************************************************/

/*****************************************************************************
 * Public functions
 ****************************************************************************/

/**
 * @brief	Handle interrupt from GPIO pin or GPIO pin mapped to PININT
 * @return	Nothing
 */
void PININT_IRQ_HANDLER(void)
{
	Chip_PININT_ClearIntStatus(LPC_GPIO_PIN_INT, PININTCH(PININT_INDEX));
	Board_LED_Toggle(0);

}

void delay_zorza( int i ){
	while(i--);
}
/**
 * @brief	Main program body
 * @return	Does not return
 */
int main(void)
{
	/* Generic Initialization */
	SystemCoreClockUpdate();

	/* Board_Init calls Chip_GPIO_Init and enables GPIO clock if needed,
	   Chip_GPIO_Init is not called again */
	Board_Init();
	Board_LED_Set(0, false);

	Chip_SCU_PinMuxSet(6, 1,(SCU_MODE_INBUFF_EN | SCU_MODE_INACT | TEST_INPUT_MODE_FUNC) );
	Chip_GPIO_SetPinDIROutput(LPC_GPIO_PORT, 3, 0);	//Pin de salida
	Chip_GPIO_SetPinState(LPC_GPIO_PORT, 3, 0, (bool) false);

	/* Set pin back to GPIO (on some boards may have been changed to something
	   else by Board_Init()) */
	Chip_SCU_PinMuxSet(TEST_INPUT_PIN_PORT, TEST_INPUT_PIN_BIT,
					   (SCU_MODE_INBUFF_EN | SCU_MODE_INACT | TEST_INPUT_MODE_FUNC) );

	/* Configure GPIO pin as input */
	Chip_GPIO_SetPinDIRInput(LPC_GPIO_PORT, TEST_INPUT_PORT, TEST_INPUT_PIN);

	/* Configure interrupt channel for the GPIO pin in SysCon block */
	Chip_SCU_GPIOIntPinSel(PININT_INDEX, TEST_INPUT_PORT, TEST_INPUT_PIN);

	/* Configure channel interrupt as edge sensitive and falling edge interrupt */
	Chip_PININT_ClearIntStatus(LPC_GPIO_PIN_INT, PININTCH(PININT_INDEX));
	Chip_PININT_SetPinModeEdge(LPC_GPIO_PIN_INT, PININTCH(PININT_INDEX));
	LPC_GPIO_PIN_INT->SIENR |= PININTCH(PININT_INDEX);
	LPC_GPIO_PIN_INT->IENF |= PININTCH(PININT_INDEX);

	Chip_PININT_EnableIntLow(LPC_GPIO_PIN_INT, PININTCH(PININT_INDEX));
	/* Enable interrupt in the NVIC */
	NVIC_ClearPendingIRQ(PININT_NVIC_NAME);
	NVIC_EnableIRQ(PININT_NVIC_NAME);

	/* Spin in a loop here.  All the work is done in ISR. */
	while (1) {
		__WFI();
		delay_zorza(35000);
		Chip_GPIO_SetPinState(LPC_GPIO_PORT, 3, 0,true);
		delay_zorza(5000);
		Chip_GPIO_SetPinState(LPC_GPIO_PORT, 3, 0,false);
	}
}
