nicozorza/TP_Final_Embebidos/Pruebas/Prueba_sAPI/firmware_edu-ciaa/projects/on_off_controller/inc/main.h

/* Copyright 2015, Pablo Ridolfi
 * All rights reserved.
 *
 * This file is part of lpc1769_template.
 *
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
 * 3. Neither the name of the copyright holder nor the names of its
 *    contributors may be used to endorse or promote products derived from this
 *    software without specific prior written permission.
 *
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
 */

#ifndef _MAIN_H_
#define _MAIN_H_

/** \addtogroup rtos_blink FreeRTOS blink example
 ** @{ */

/*==================[inclusions]=============================================*/

/*==================[cplusplus]==============================================*/

#ifdef __cplusplus
extern "C" {
#endif

/*==================[macros]=================================================*/

/*==================[typedef]================================================*/

/*==================[external data declaration]==============================*/

/*==================[external functions declaration]=========================*/

#include "../../on_off_controller/inc/main.h"

#include "../../on_off_controller/inc/FreeRTOSConfig.h"
#include "board.h"

#include "FreeRTOS.h"
#include "task.h"
#include "semphr.h"


/** @brief main function
 * @return main function should never return
 */
int main(void);

/*==================[cplusplus]==============================================*/

#ifdef __cplusplus
}
#endif

/** @} doxygen end group definition */
/*==================[end of file]============================================*/
#endif /* #ifndef _MAIN_H_ */
