nicozorza/TP_Final_Embebidos/(commit log)

2017-05-05 Empece el proyecto de prueba del puerto serie, donde la idea es armar las librerias para no tener que utilizar DEBUGOUT, etc.
    [lpc4337.cfg]
2017-05-05 Hay algun lio con los pines del SCU porque no coinciden con los de la hoja de datos, y por eso solo me anda el UART2 y no los demas
2017-05-06 Empece a probar el ADC. El problema con el puerto serie es que la UART2 es la que esta conectada a la salida USB, entonces para probar los demas puertos de USB tengo que conectar el conversor. Esto l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
    [lpc4337.cfg]
2017-05-06 Borro todo porque por alguna razon me quedo todo mal configurado. Vuelvo a empezar
    [lpc4337.cfg]
2017-05-06 Probe el ejemplo del adc importado. No encontre porque no me andaba el puerto serie antes, pero mañana lo voy a revisar. Seguro que estoy creando mal el proyecto desde el inicio y por eso explota
    [lpc4337.cfg]
2017-05-06 No pude crear un proyecto para probar el ADC desde cero, asi que termine copiando un proyecto ya creado.
    [lpc4337.cfg]
2017-05-06 Agrego informacion sobre el BurstMode del ADC
2017-05-06 Empece a probar el pwm. Simplemente importe el ejemplo que hay, pero creo que sin osciloscopio no voy a poder ver bien como funciona. Voy a probar midiendo el valor medio.
    [lpc4337.cfg]
2017-05-07 Estuve investigando sobre la generacion de PWM, y agregando datos al readme.md. Estaba viendo sobre el tema de las interrupciones del sct pero me voy a jugar al fulbito
2017-05-08 Al parecer ya anda el PWM (configurandolo segun lo que puse en el README.md). Faltaria averiguar sobre el tema de las interrupciones del pwm y de la otra configuracion que esta en el datasheet. El si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
    [lpc4337.cfg]
2017-05-09 Empece a armar un proyecto de prueba para un controlador PID. La idea es poner un pote y ver si funciona: Entro con tension y salgo con pwm. Si esto funciona ya puedo probar de controlar la temperatu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
    [lpc4337.cfg]
2017-05-09 Lo que hice fue leer un valor del adc, y utilizarlo para modificar el valor de PWM en un rango entre 0-100%. Esto funciono perfectamente, asi que tengo que ver que onda lo del PID (todavia la placa n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
2017-05-09 Agregue una pequeña simulacion para un controlador PID de tiempo discreto, ya que nunca habia hecho nada de eso. Parece funcionar bien, pero no hice ninguna cuenta asi que esta puesto todo a ojo
2017-05-09 Supuestamente deje todo listo para probar el PID: Hay que cerrar el lazo de realimentacion y ver si funciona. Cuando tenga la bornera hay la prueba posta
2017-05-10 Probe el PID por software y anduvo hermoso. Ahora falta cerrar el lazo de forma física, y ya va a estar todo listo para hacer el control de temperatura
2017-05-10 Modifique unas cositas para que quede mas prolijo el README.md
2017-05-19 Arme los circuitos de deteccion de fase y disparo del tiristor. Cree un proyecto (Prueba_detectar_fase) donde activo las interrupcione de entrada de un pin (para detectar los cruces), meto un delay, 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
    [lpc4337.cfg]
2017-05-19 Agregue un proyecto cabeza que utiliza interrupciones en un pin de entrada para sincronizar una senoidal con lo que seria el disparo del gate del triac (Prueba_detectar_fase). Funciono perfectamente,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
2017-05-21 Arme el proyecto Prueba_cambiar_valor_eficaz, donde lo que hago es con un pote variar la tension de un canal del adc, y en funcion de esa tension cambio el valor eficaz de la altera. Para esto lo que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
    [lpc4337.cfg]
2017-05-22 Empece a hacer el esquematico. No se si hacer un poncho o una placa separada, porque no me gusta mucho la idea de tener la potencia cerca del micro, a pesar de tener todo con optoacopladores
    [esquematico.sch]
2017-05-22 Reorganice el proyecto un poco porque estaba todo re tirado
    [lpc4337.cfg]
2017-05-22 Empece a escribir el codigo en FreeRTOS. Mas o menos ya pase todo lo que habia hecho antes de forma cabeza, y ahora estoy viendo el tema de la configuracion del timer. Me voy a almorzar y despues sigo
    [lpc4337.cfg]
2017-05-22 Modifique algunas cosas en la parte del trigger. Me parece que conviene probar bien todo antes de seguir avanzando, porque me genera dudas los retardos que puede meter el scheduler
2017-05-23 No me habia dado cuenta, pero las librerias que estaba importando tenian la frecuencia del clock dividida por 4. Eso se lo saque, ya que necesito hacer todo a la mayor velocidad posible
2017-05-23 Empece a probar el codigo de FreeRTOS con el circuito. Cada tanto se cuelga, pero no encuentro la razon (el codigo salta a un handler por default, pero lo hace antes de entrar al codigo posta). Esta 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
2017-05-23 No logre ningun resultado positivo con las funciones bloqueantes de FreeRTOS. Ahora esta puesto un delay con un while, pero estuve ajustando algunos numeros para que funcione mejor
2017-05-24 Probe algunas cosas con el sensor de temperatura. Arme un proyectito bien choto que lee el ADC (donde esta conectado el circuito del sensor de temperatura) y lo manda por el puerto serie
    [lpc4337.cfg]
2017-05-24 Agregue el circuito de la termocupla al esquematico de Eagle. Falta definir si vamos a meter el PT100 como referencia
    [esquematico.sch]
2017-05-24 Agregue unas cosas para los sensores de temperatura. No pude hacer bien la calibracion con el pt100, porque ambos sensores miden la misma temperatura (supuestamente la suma de ambas temperaturas da l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
2017-05-24 Agregue al PCB un regulador de 3.3v porque la EDU-CIAA labura con esa tension, y sino iba a tener problemas con el ADC. Tendria que probar que la parte de control siga funcionando bien, pero segun la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
    [esquematico.sch]
2017-05-25 Estuve probando de hacer el delay del trigger con un timer pero no tuve exito. Cambie un par de macros y emprolije algunas cosas con las pruebas de FreeRTOS
2017-05-26 Cambie las resistencias del PCB a smd. Tambien modifique las borneras para usar unas de 5mm
    [esquematico.sch]
2017-05-26 Agregue los valores de algunas resistencias que me faltaban, agregue el pt100, y agregue un pdf con una foto del esquematico para poder revisarlo mas facil sin abrir eagle
    [esquematico.sch]
2017-05-26 Pude hacer el delay que mantiene encendido al trigger con una interrupcion del timer. Tambien agregue una variable global que hace que el valor del ADC se actualice cada 500ms, que es un poco mas raz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
2017-05-26 Reorganice un par de cosas para no tener variables auxiliares al pedo.
2017-05-28 Agregue la tarea del PID. Use las cosas que habia hecho en las pruebas anteriores del PID, pero antes lo habia hecho con pwm, y como ahora es con la temperatura, estoy seguro de como relacionarla con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
2017-05-29 Estuve viendo el tema del controlador. Esta funcionando medio mal, pero no se si es por culpa del software o del hardware. Estoy siguiendo una temperatura de referencia, pero no lo hago demasiado rap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
2017-05-29 Cambie el PID por un P, y parece estar andando bien. Los cambios de temperatura son un poco lentos, pero no se si es por el controlador o porque a la resistencia no le da la potencia. Esta todo medio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
2017-05-30 Cambie todo para usar el controlador proporcional. Estuve emprolijando un poco las cosas. Tendria que empezar a separar las cosas en archivos
2017-05-30 Estuve calibrando un poco los limites del delay del trigger. Tendria que hacerlo con un osciloscopio igual...
2017-05-30 Estuve presentando los componentes en la placa para ver mas o menos como va a quedar
    [esquematico.brd, esquematico.sch]
2017-06-01 Agrego el firmware de la EDU-CIAA para tenerlo en el repositorio
2017-06-01 Configure el path del sAPI y ahora compila. Mañana voy a probar si realmente anda o hice cualquier cosa
2017-06-01 El firmware de la edu-ciaa tenia un gitignore que hizo que no se subieran las cosas a mi github. Ahora lo borre y lo tengo de repuesto por si rompo todo
    [ctestcases.cfg, lpc1769.cfg, lpc4337.cfg, lpc4337_cd.cfg, lpc54102_cd.cfg, testcases.cfg]
2017-06-01 Logre compilar y debuggear con la sAPI. El proyecto de FreeRTOS que habia hecho se puede usar directamente con la sAPI (falta probarlo, pero compila, asi que seguro anda)
    [ctestcases.cfg, lpc1769.cfg, lpc4337.cfg, lpc4337_cd.cfg, lpc54102_cd.cfg, testcases.cfg]
2017-06-01 Estuve probando con sAPI mi codigo de FreeRTOS y parece que anda bien. Tengo que empezar a reemplazar las funciones por las de la sAPI
2017-06-02 Estuve ruteando el PCB. Creo que esta terminado, pero tendria que revisarlo menos dormido
    [esquematico.brd, esquematico.sch]
2017-06-02 Me puse a escribir un poco el codigo para un proyecto que en lugar de usar un controlador P, usa un controlador On-Off. No lo pude probar, pero deberia andar. La idea de esto es hacer que se alcance 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
2017-06-04 Tuve unos problemas con las librerias que importe de sAPI, ya que tenian archivos de gitignore que no habia visto. Por culpa de esto perdi todo lo que habia hecho.... Volvi a usar directamente el sof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
    [lpc4337.cfg]
2017-06-04 Arregle unas cosas que faltaban, y hacian que los botones de encendido y apagado rompan todo
2017-06-04 Agregue la tarea que va modificando el valor de la referencia con el paso del tiempo. Parece estar funcionando bien, asi que deberia probar haciendo que siga alguna curva especifica (probe con un vec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
    [Configure.c, main.h]
2017-06-04 Borre lo del PT100 y agrege las cosas para hacer el control del cooler. Falta ordenar un poco, ver si se puede achicar mas, y volver a rutear
    [esquematico.brd, esquematico.sch]
2017-06-04 El PCB esta listo para ser imprimido. Voy a comprar todos los componentes mañana y ya lo termino
    [esquematico.brd]
2017-06-04 Movi unas cosas para que entren mejor los disipadores
    [esquematico.brd]
2017-06-10 Tuve que rehacer la placa porque habian quedado muy finas las pistas. El codigo no lo modifique, y parece estar andando todo bien. Mañana le voy a poner disipadores a los triacs y voy a empezar a pon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
    [esquematico.brd, esquematico.sch]
2017-06-10 Estuve avanzando un poco con la actualizacion de la referencia de temperatura. Pude seguir una curva de temperatura escalada. La termocupla no esta bien calibrada, asi que mas tarde la voy a volver a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
2017-06-12 Actualice la calibracion de la termocupla
2017-06-12 Estuve jugando con la curva de referencia de temperatura del controlador
2017-06-13 Hice un control proporcional por ciclos enteros para el horno. Funciona mejor que el control on-off
    [lpc4337.cfg]
2017-06-13 Agregue unas macros para las prioridades de las tareas
2017-06-13 Corregí el problema que tenia con los botones de apagado y encendido. La funcion vTaskDelayUntil me arruinaba todo, asi que puse vTaskDelay y listo
    [Configure.h, main.c]
2017-06-13 Modifique las prioridades de las tareas y un par de cositas mas
2017-06-16 Agregue la tarea tarea que controla el cooler
2017-06-21 Modifique un par de cosas: la ganancia del opamp, los valores de la curva, y un par de detalles mas
2017-06-22 Deje la ultima version que utilizamos, donde uni medio villeramente mi codigo con el de Lio. Agregue tambien las cosas que tenia tiradas en dropbox. El proyecto ya esta terminado, asi que me despido 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
    [lpc4337.cfg]
2017-06-22 Me habia olvidado de subir los videos del proyecto
